HaydenYu916/Hao_MTRN4231/src/robot_description/meshes/wholedraft1.stl

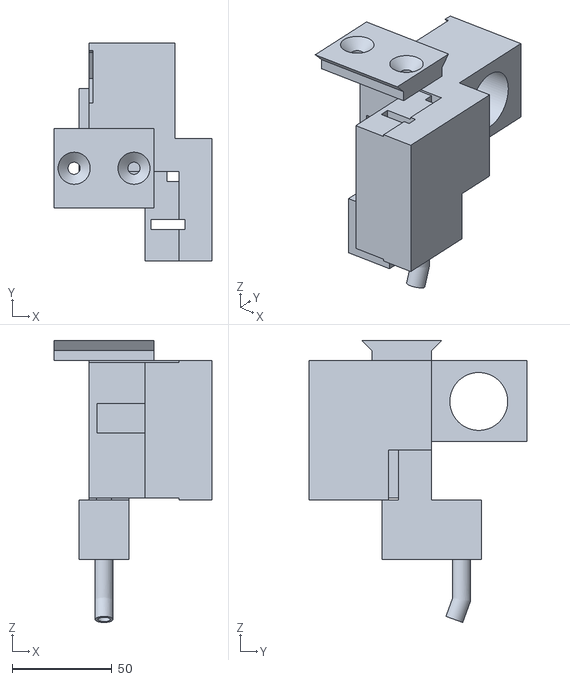
[picture p4: CAD file, 2025-11-26]
src/robot_description/meshes/wholedraft1.stl
79.0 x 109.5 x 141.4
