HaydenYu916/Hao_MTRN4231/assest/CustomEndEffector/STL Files/ProvidedMount.stl

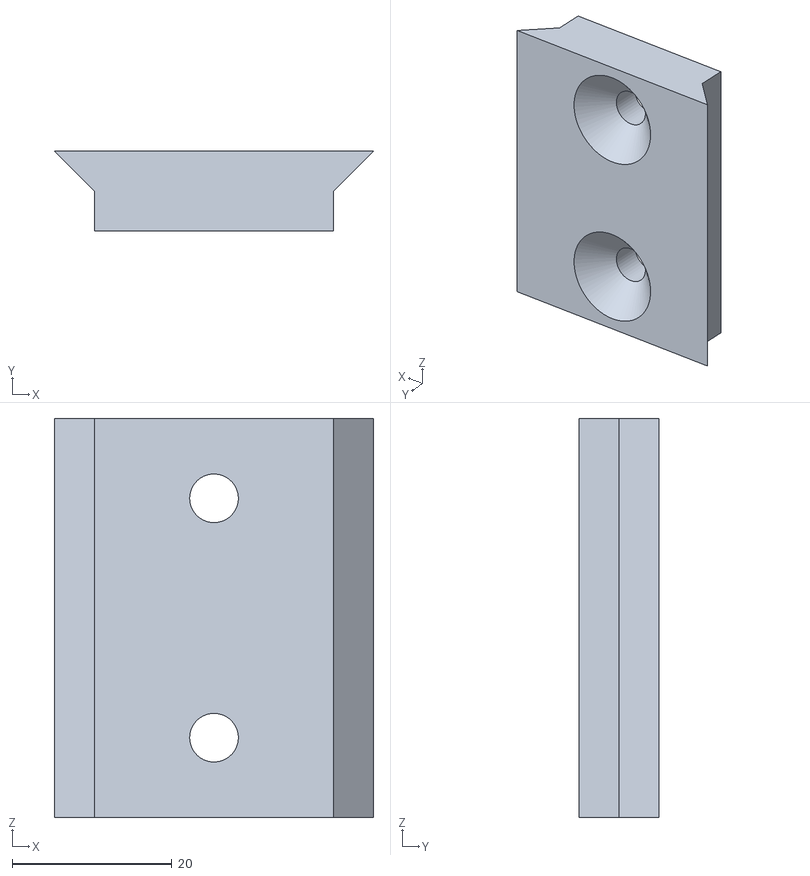
[picture p5: CAD file, 2025-12-04]
assest/CustomEndEffector/STL Files/ProvidedMount.stl
40.0 x 10.0 x 50.0
