HaydenYu916/Hao_MTRN4231/src/robot_description/meshes/camera.stl

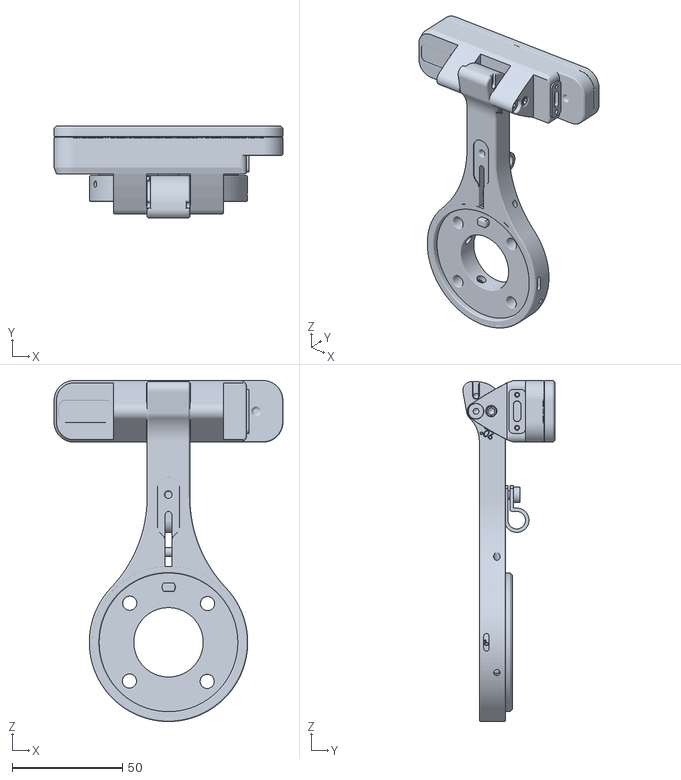
[picture p6: CAD file, 2025-11-18]
src/robot_description/meshes/camera.stl
104.0 x 42.0 x 155.0
