HaydenYu916/Hao_MTRN4231/assest/CustomEndEffector/STL Files/SprayMountBox.stl

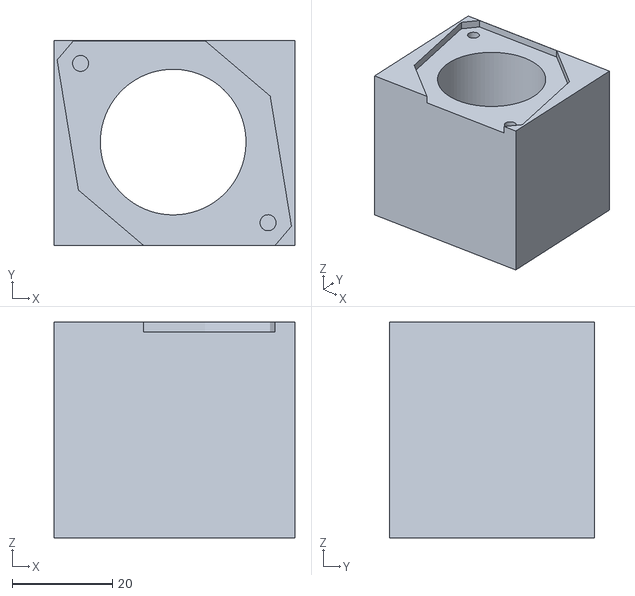
[picture p7: CAD file, 2025-12-04]
assest/CustomEndEffector/STL Files/SprayMountBox.stl
48.0 x 40.8 x 43.0
