HaydenYu916/Hao_MTRN4231/src/robot_description/meshes/QC.stl

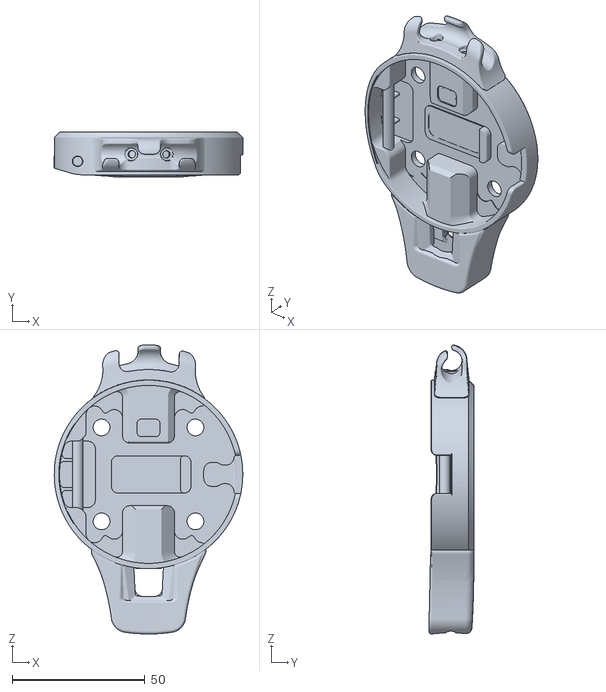
[picture p8: CAD file, 2025-11-18]
src/robot_description/meshes/QC.stl
71.0 x 17.1 x 108.8
