HaydenYu916/Hao_MTRN4231/assest/CustomEndEffector/STL Files/VacuumPumpMount.stl

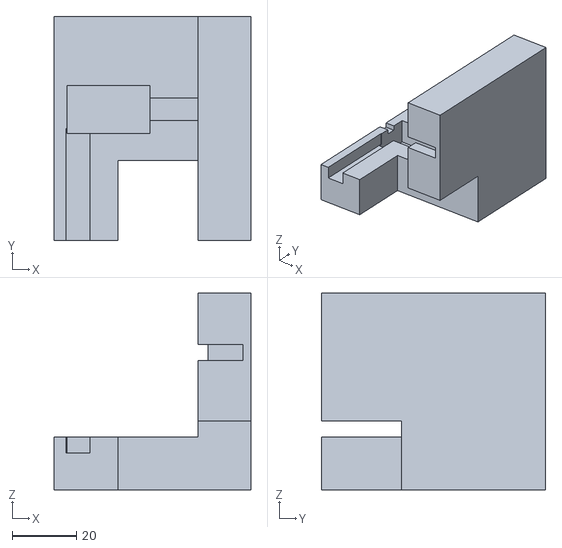
[picture p9: CAD file, 2025-12-04]
assest/CustomEndEffector/STL Files/VacuumPumpMount.stl
61.5 x 70.0 x 61.5
