HaydenYu916/Hao_MTRN4231/assest/CustomEndEffector/STL Files/ClosingMount.stl

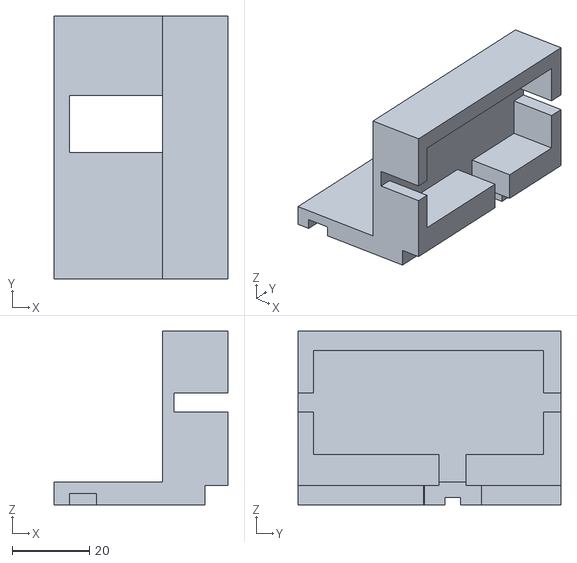
[picture p10: CAD file, 2025-12-04]
assest/CustomEndEffector/STL Files/ClosingMount.stl
45.0 x 68.0 x 45.0
