HaydenYu916/Hao_MTRN4231/assest/CustomEndEffector/STL Files/EndEffectorComponent.stl

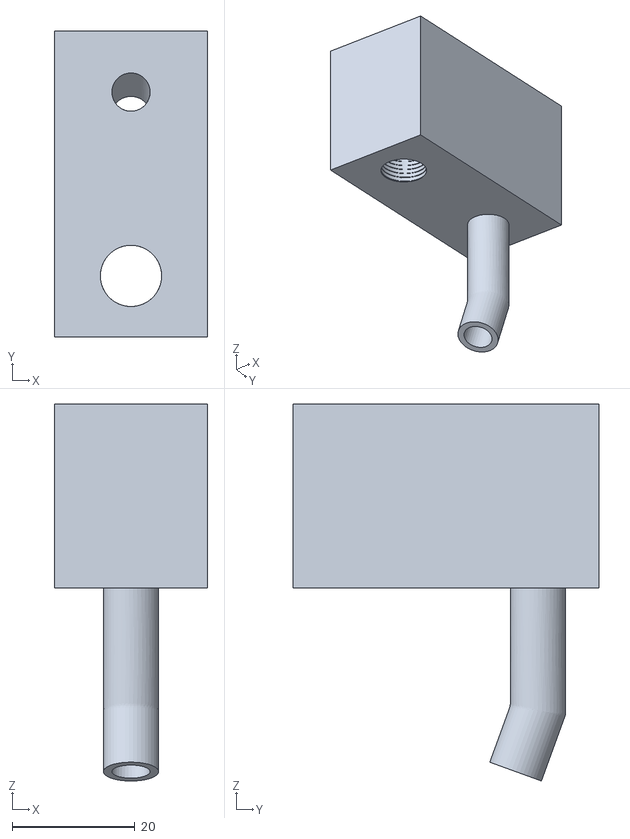
[picture p11: CAD file, 2025-12-04]
assest/CustomEndEffector/STL Files/EndEffectorComponent.stl
25.0 x 50.0 x 61.5
