HaydenYu916/Hao_MTRN4231/(list of files, cad)

Other CAD files:
assest/CustomEndEffector/STL Files/FullAssembly.stl
