HaydenYu916/Hao_MTRN4231/assest/CustomEndEffector/Drawings/FullAssemblyDrawing.pdf

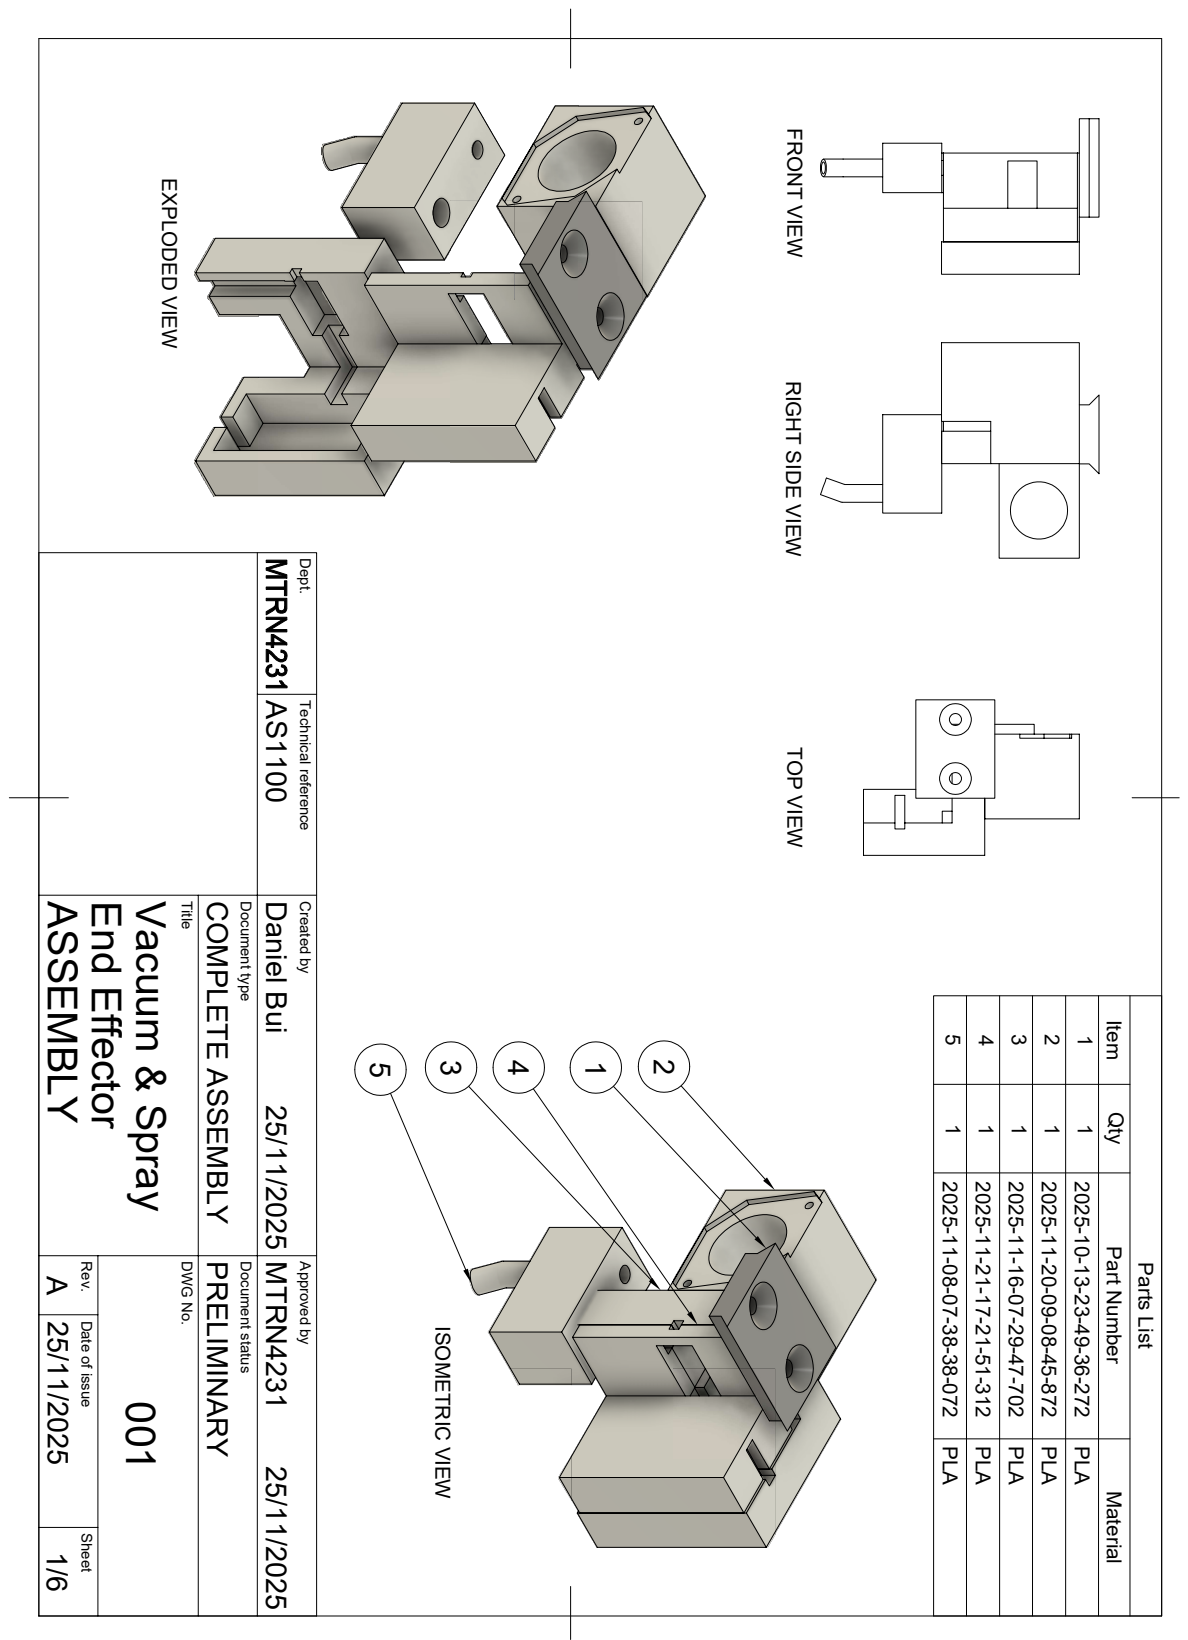
[picture p12: page 1]
2 EXPLODED VIEW

A ASSEMBLY PRELIMINARY COMPLETE ASSEMBLY 25/11/2025 25/11/2025 1/6 End Effector 001 Vacuum & Spray MTRN4231 Daniel Bui AS1100 FRONT VIEW TOP VIEW RIGHT SIDE VIEW ISOMETRIC VIEW Parts List Item Qty Part Number Material 1 1 2025-10-13-23-49-36-272 PLA 2 1 2025-11-20-09-08-45-872 PLA 3 1 2025-11-16-07-29-47-702 PLA 4 1 2025-11-21-17-21-51-312 PLA 5 1 2025-11-08-07-38-38-072 PLA

Dept. Technical reference Created by Approved by Title DWG No. Document type Document status Rev. Date of issue Sheet 25/11/2025
