HaydenYu916/Hao_MTRN4231/(commit log)

2025-11-02 Initial commit: ROS2 URDF workspace with all English translations
    [ur5e_with_camera.xacro]
2025-11-03 version1 without end-effector
    [end_effector.urdf.xacro]
2025-11-17 add unheal leaf detection
    [end_effector.urdf.xacro]
2025-11-18 更新项目文件：添加动态障碍物监控、更新机器人描述和任务自动化功能
    [QC.stl, camera.stl, ur5e_with_camera.xacro]
2025-11-25 add arduino
2025-11-26 english comment v1
    [end_effector.urdf.xacro, ur5e_with_camera.xacro, wholedraft1.stl]
2025-11-27 remain xcaro for end-effector can not finish yet
    [joint_limits.yaml, ur5e_with_camera.xacro]
2025-11-28 try use customize urdf
2025-12-01 Fix MoveIt issue: set tool_point to top of gripper
2025-12-04 add readme
    [ClosingMount.stl, EndEffectorComponent.stl, FullAssembly.stl, ProvidedMount.stl, SprayMountBox.stl, VacuumPumpMount.stl]
